UkuleleDesign/LightningUke/README.md

# LightningUke
An Electric Ukulele DIY Kit

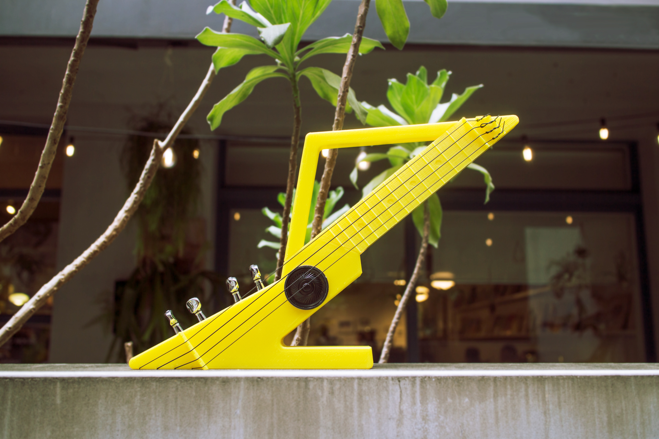
[picture p1: images/heroshot.jpg]
shot


Find out more at [Ukulele.Design](https://ukulele.design/).
