UkuleleDesign/LightningUke/ComponentList.md

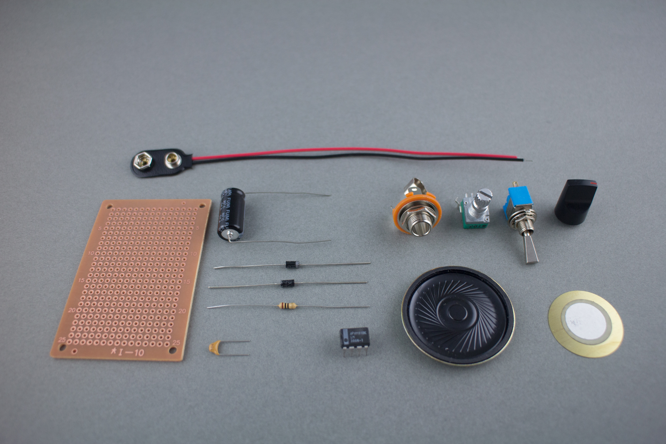
[picture p2: instructions/IMG_3865.jpg]
parts


## Electronic Parts

- pegboard x 1
- LM386 x 1
- 10Ω resistor x 1
- 0.1μF (104) capacitor x 1
- 220μF capacitor x 1
- 10KΩ potentiometer x 1
- knob x 1
- 1W 8Ω 40mm speaker x 1
- switch x 1
- 9V battery snap x 1
- 27mm piezo x 1

## Purchased Parts
- geared tuners x 4
- 21 inch ukulele nylon strings x 4
- 6.3mm jack x 1

## 3D Printed Parts
- neck x 1
- handle x 1
- body x 1
