UkuleleDesign/LightningUke/images/parts.jpg

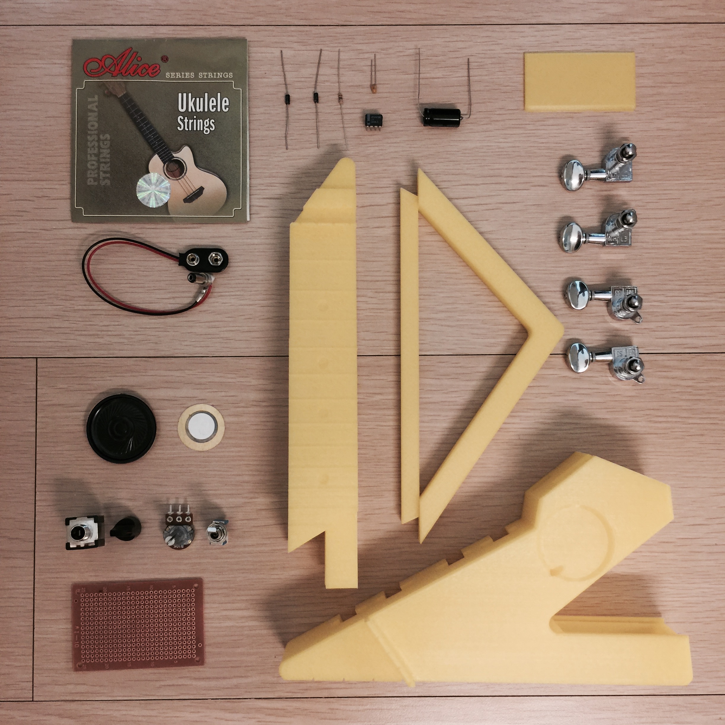
images/parts.jpg
