UkuleleDesign/LightningUke/stl/lightning-v2.step

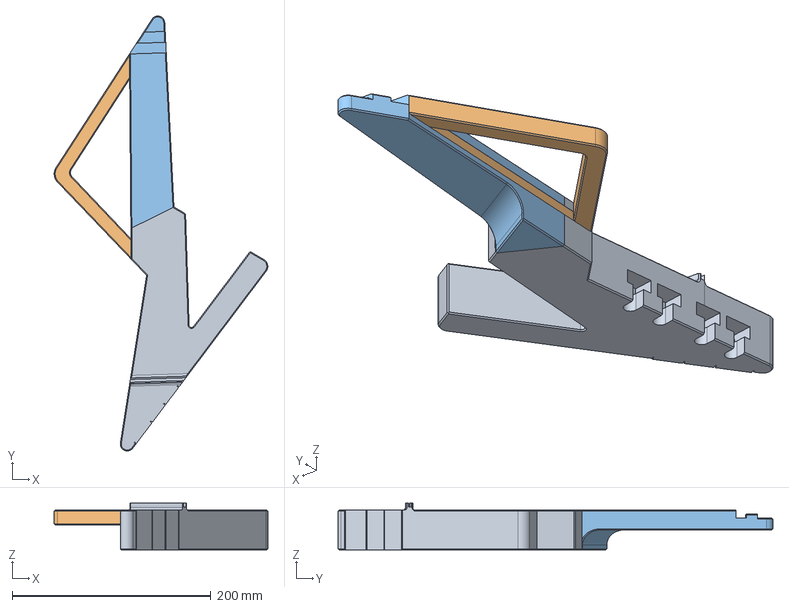
[picture p4: CAD file, 2019-11-01]
stl/lightning-v2.step
215.0 x 437.7 x 47.0 mm
