UkuleleDesign/LightningUke/stl/lightning-v21-body-solid.stl

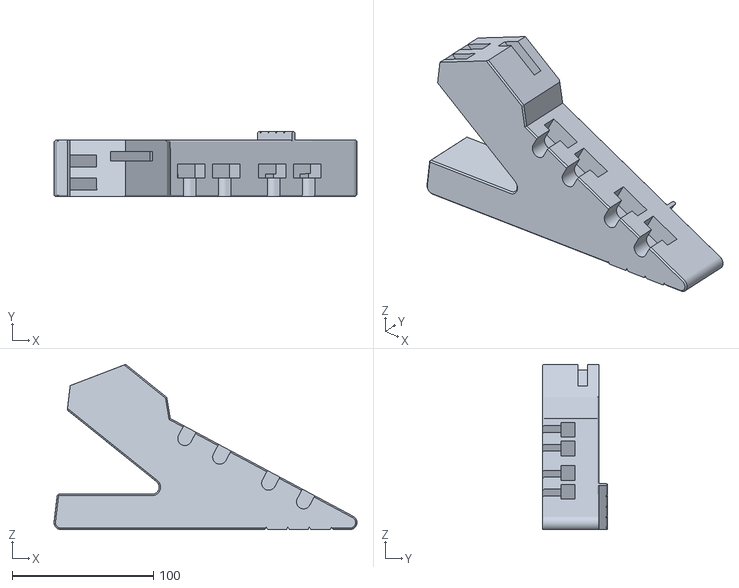
[picture p5: CAD file, 2016-09-16]
stl/lightning-v21-body-solid.stl
214.5 x 46.2 x 117.0
