UkuleleDesign/LightningUke/stl/lightning-v21-body.stl

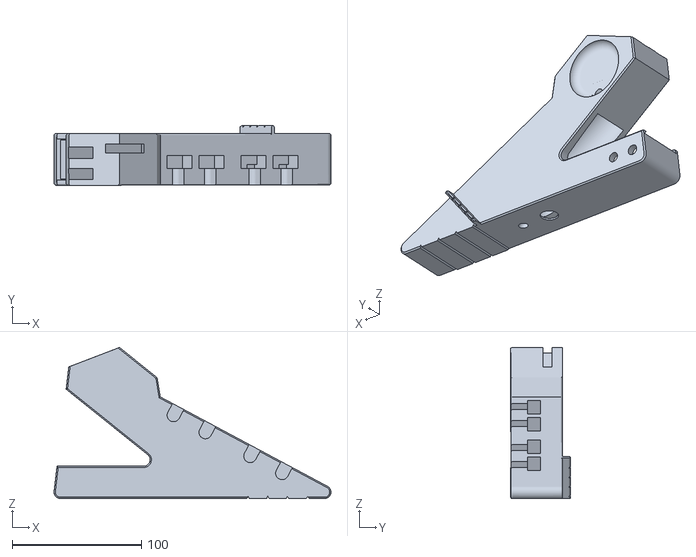
[picture p6: CAD file, 2016-09-16]
stl/lightning-v21-body.stl
214.5 x 46.2 x 117.0
