UkuleleDesign/LightningUke/stl/lightning-v20-handle.stl

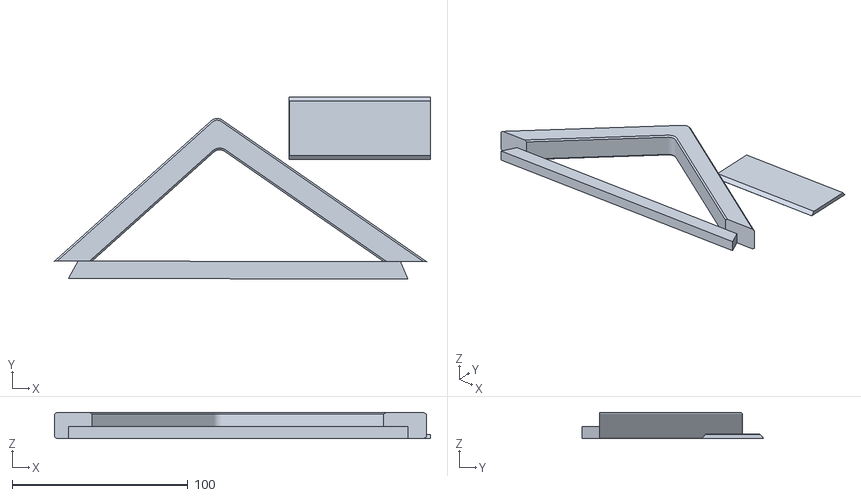
[picture p7: CAD file, 2016-08-18]
stl/lightning-v20-handle.stl
213.8 x 103.4 x 15.0
