UkuleleDesign/LightningUke/stl/lightning-v20-neck.stl

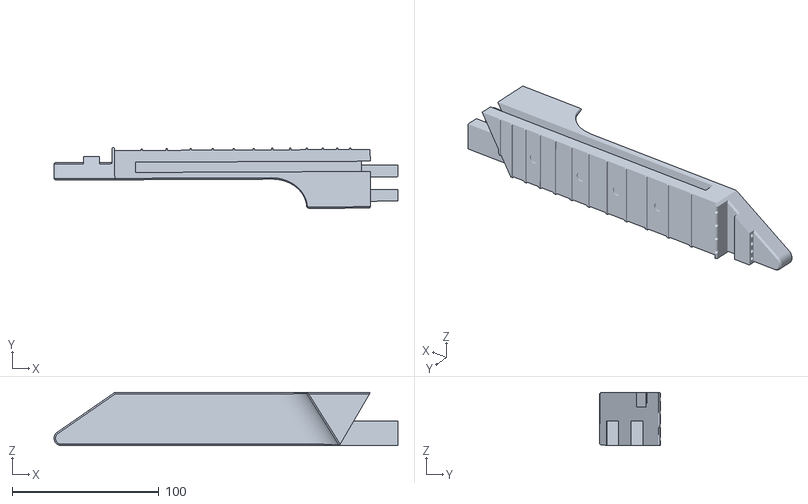
[picture p8: CAD file, 2016-08-18]
stl/lightning-v20-neck.stl
234.5 x 41.4 x 36.4
