UkuleleDesign/LightningUke/stl/lightning-v2-handle.stl

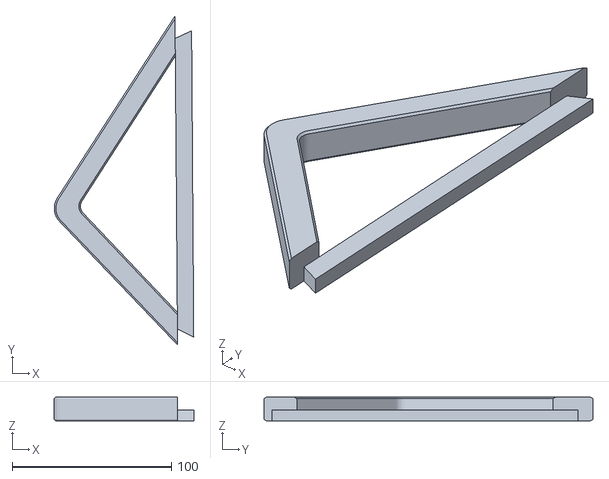
[picture p9: CAD file, 2019-11-01, an earlier design]
stl/lightning-v2-handle.stl
87.5 x 206.4 x 15.0
