UkuleleDesign/LightningUke/stl/lightning-v2-neck.stl

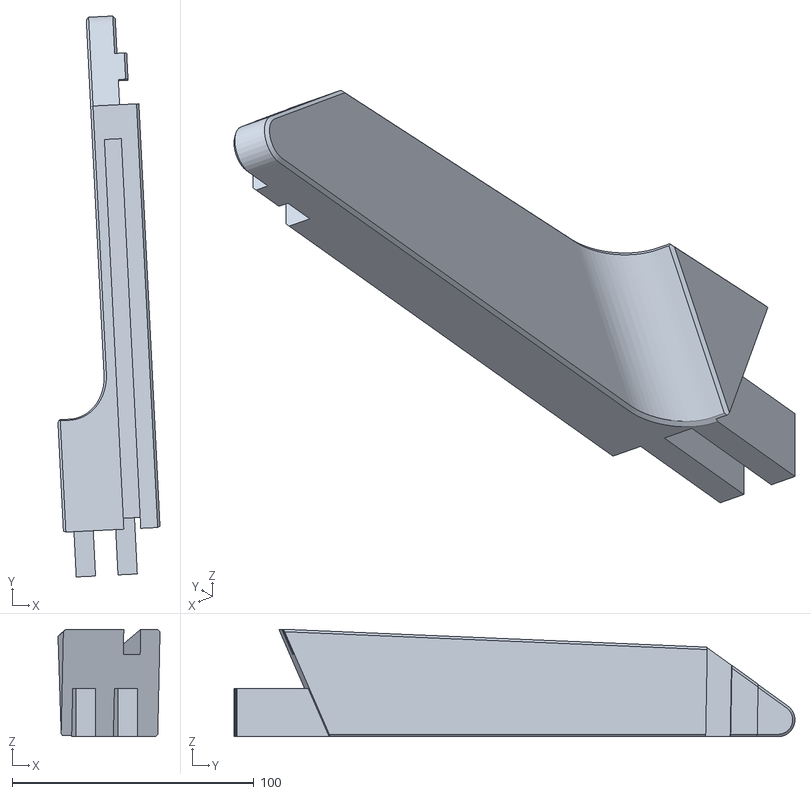
[picture p10: CAD file, 2019-11-01, an earlier design]
stl/lightning-v2-neck.stl
42.2 x 231.9 x 44.4
