UkuleleDesign/LightningUke/stl/lightning-v2-body.stl

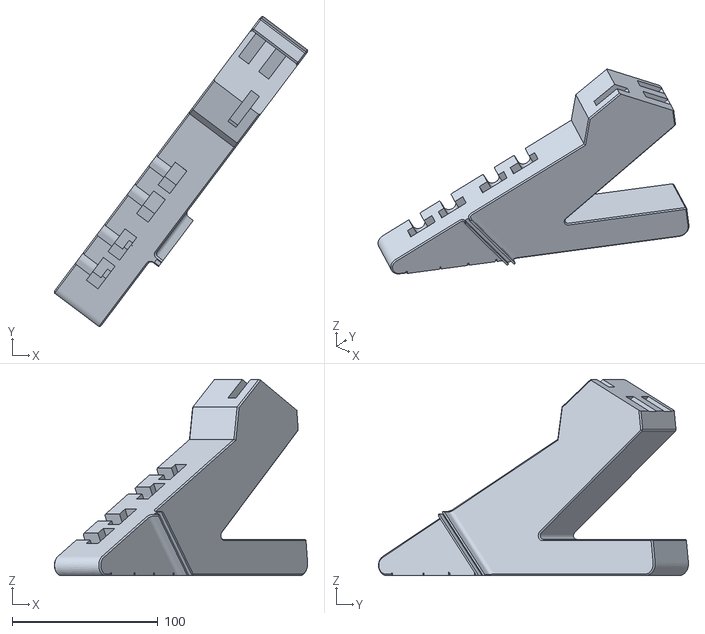
[picture p11: CAD file, 2019-11-01, an earlier design]
stl/lightning-v2-body.stl
173.9 x 212.9 x 134.7
