UkuleleDesign/LightningUke/AssemblyInstructions.md

# Lightning Uke Assembly Instructions 

## 1. Prepare Printed Parts  

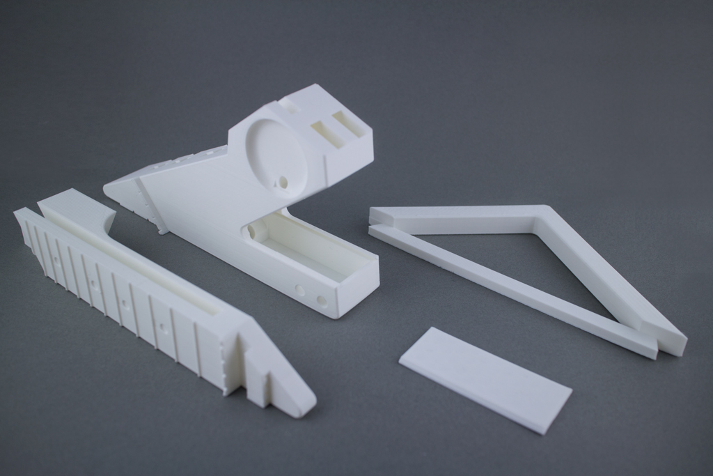
[picture p12: instructions/IMG_3761.jpg]


Download [STL files](https://github.com/UkuleleDesign/LightningUke/tree/master/stl) for 3D printing. Print all 3 files in PLA, with following configuration:

* Infill: 20%
* Layer height: 0.20 mm
* Shells: 2 
* Support material and raft: No

Depends on the printer size, you might need to rotate the model in 45 degrees

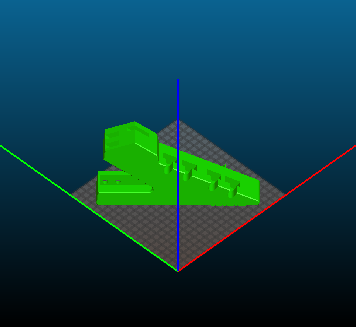
[picture p13: instructions/slic3r.png]


The whole prints takes around 15.5 hours (body: 9 hours, neck: 4 hours, handle: 2.5 hours) on a Replicator 2. You can also purchase a [DIY kit](http://ukulele.design/#purchase) from the project website
	
## 2. Assemble the Body

Slide the handle into neck, and insert joints into body

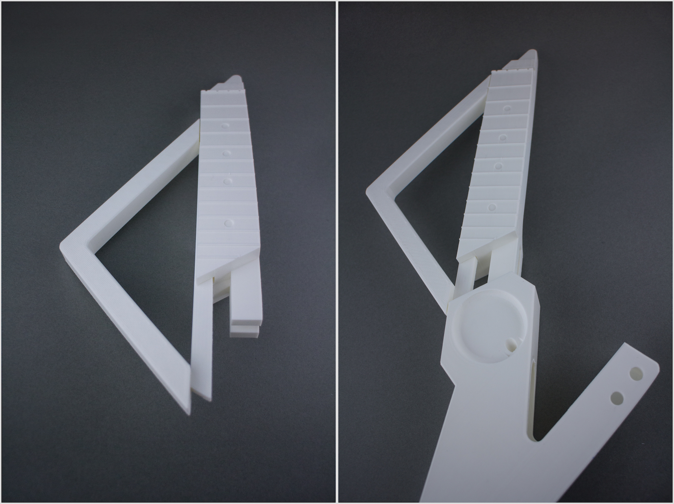
[picture p14: instructions/assemble_body.jpg]


Snap it together to finish the body 

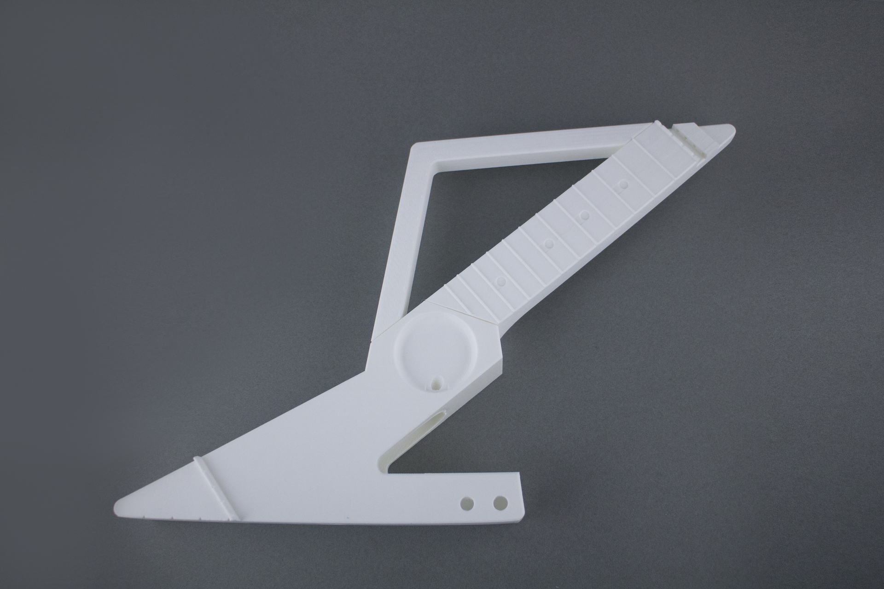
[picture p15: instructions/IMG_3788.jpg]


## 3. Install Tuners

Get 4 sealed geared tuners, note there are left and right orientations

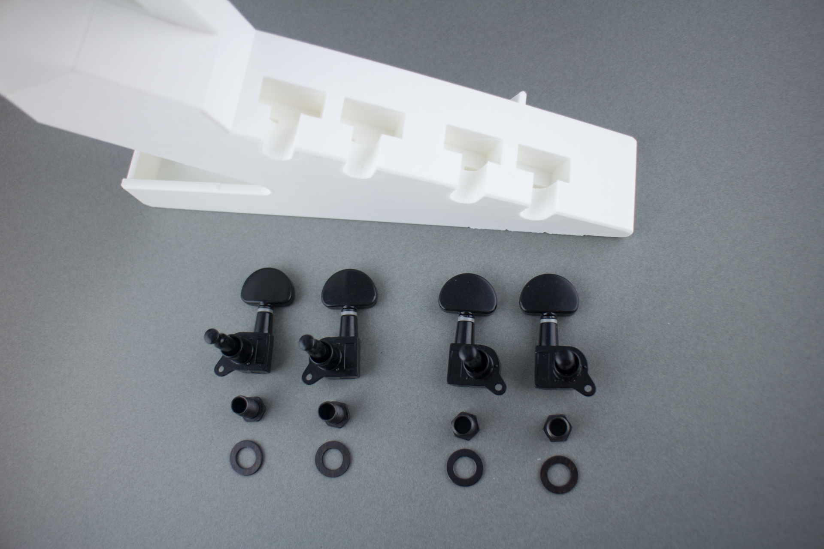
[picture p16: instructions/IMG_3799.jpg]


Slide tuners into body, tighten screw with washer

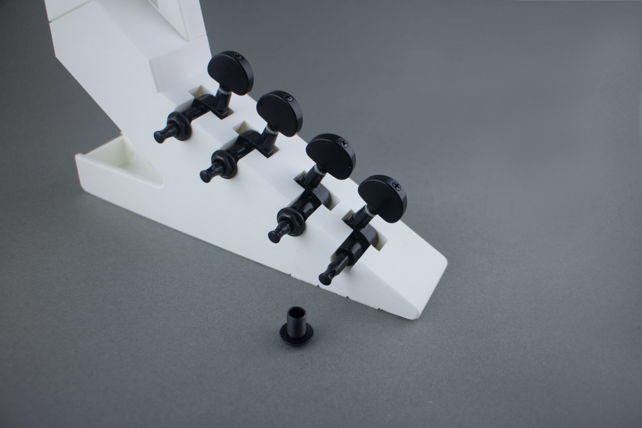
[picture p17: instructions/IMG_3805.jpg]


## 4. String It Up

Get a set of 21 inch (soprano) ukulele strings 

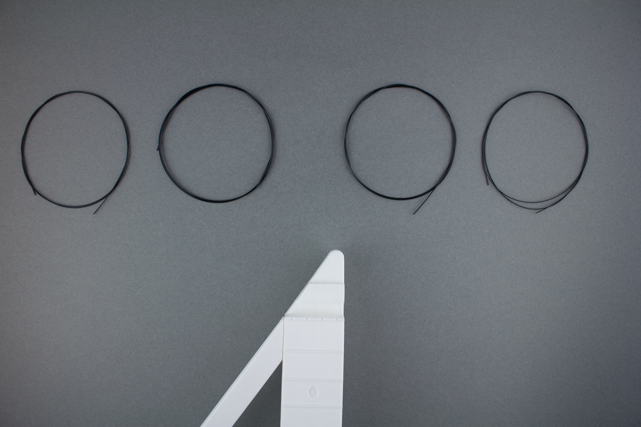
[picture p18: instructions/IMG_3813.jpg]


Start with the 4th string, insert it into the top-most hole of headstock 

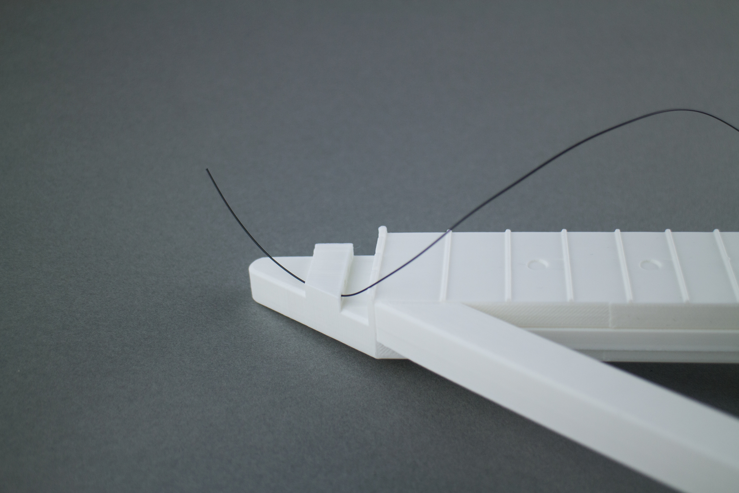
[picture p19: instructions/IMG_3818.jpg]


Go around itself for a loop

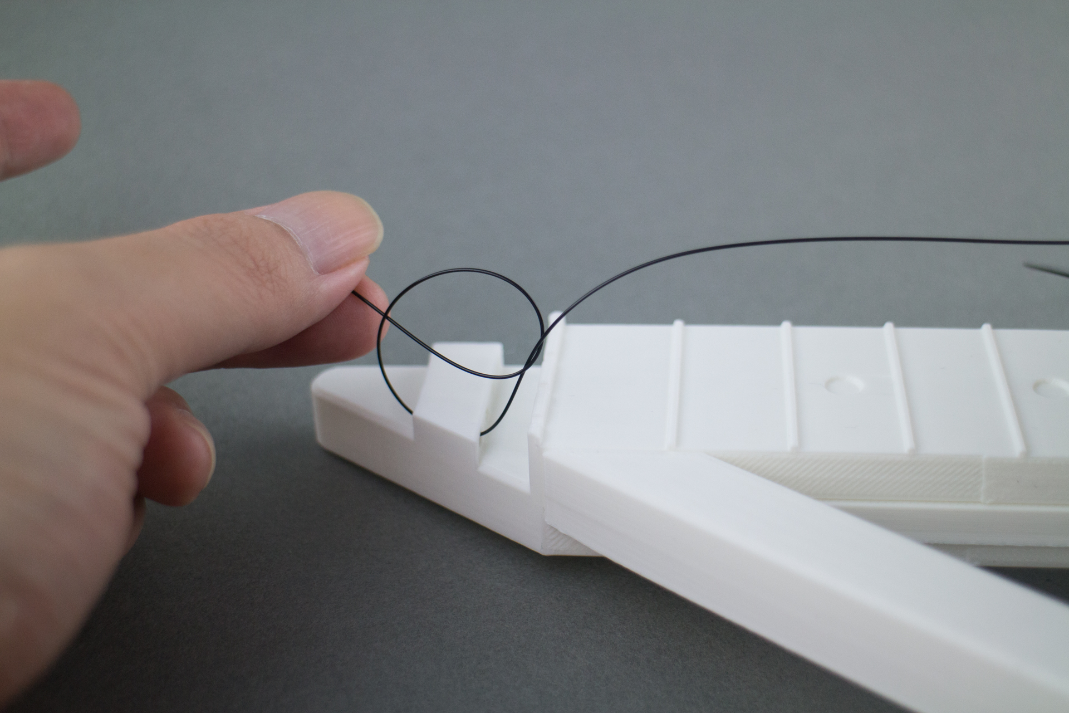
[picture p20: instructions/IMG_3822.jpg]


Make two more loops in the same direction 

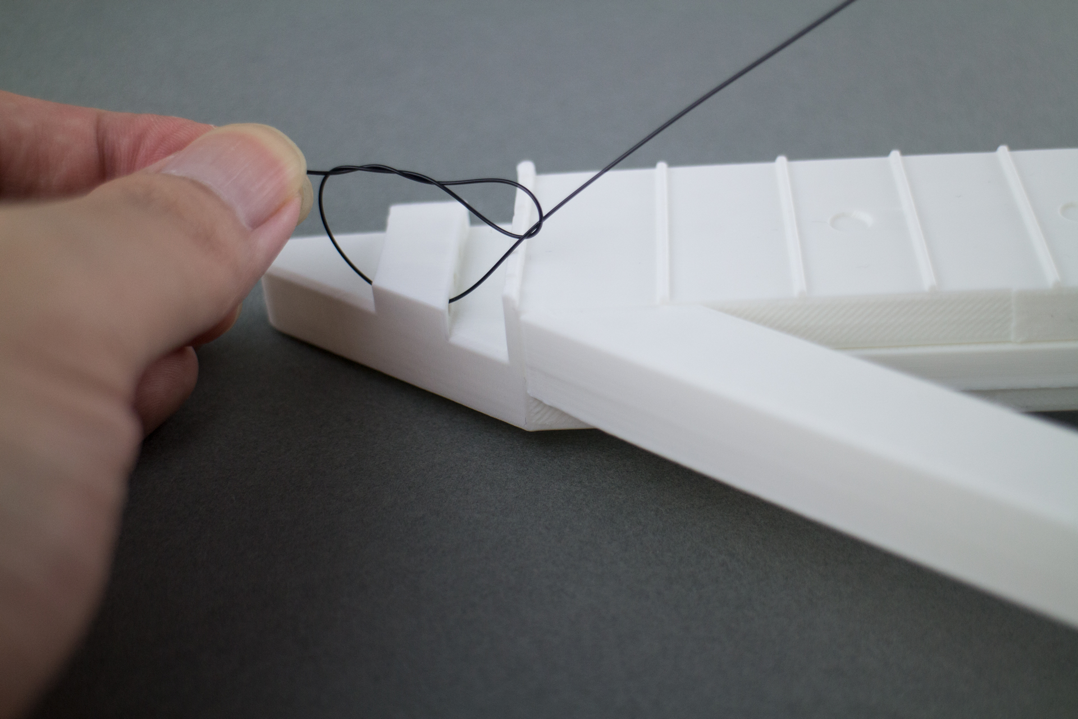
[picture p21: instructions/IMG_3823.jpg]


Pull on the long end of string to tighten the knot

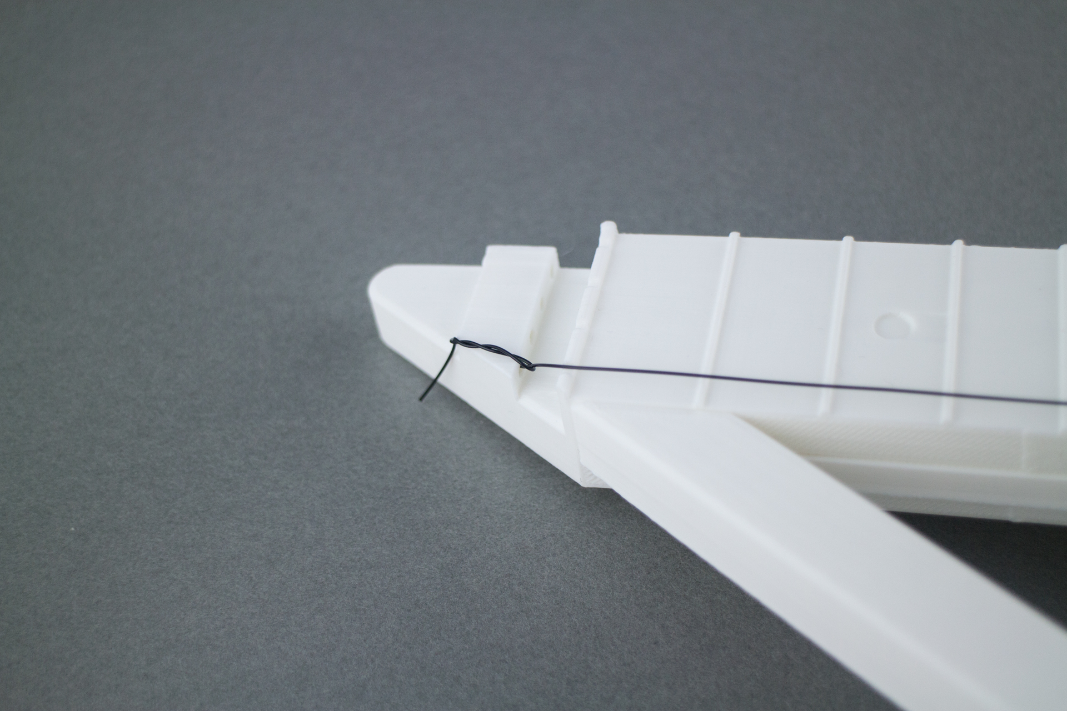
[picture p22: instructions/IMG_3825.jpg]


Wrap the string over the bridge and around the body, insert into the tuner peg hole 

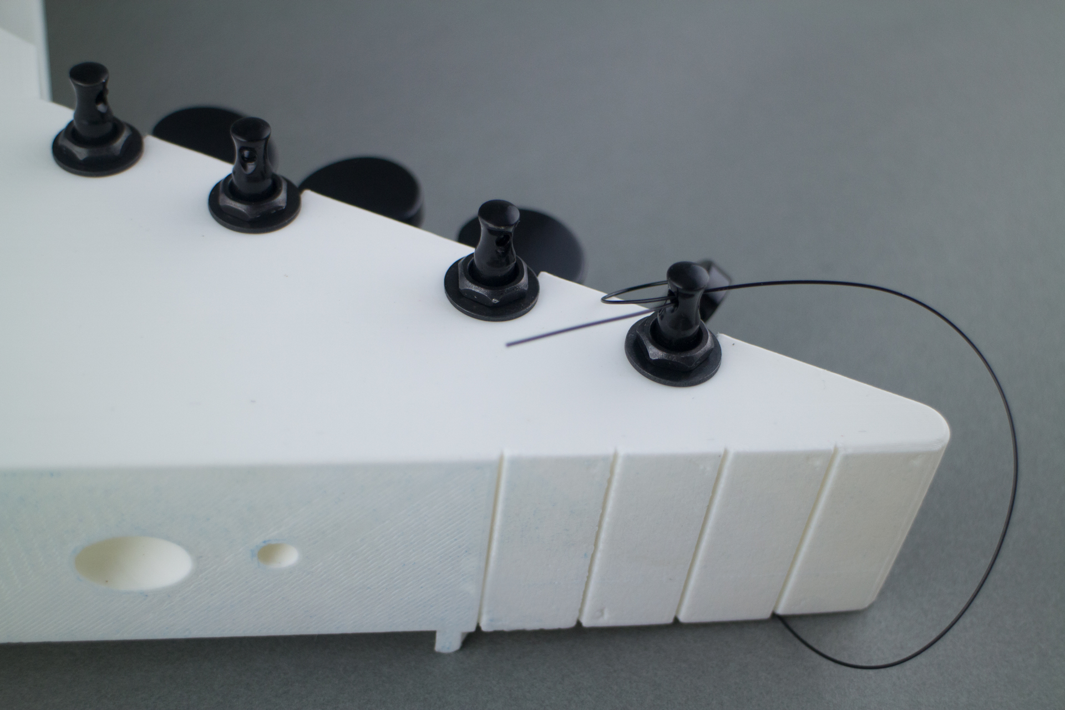
[picture p23: instructions/IMG_3836.jpg]


Tighten and tune

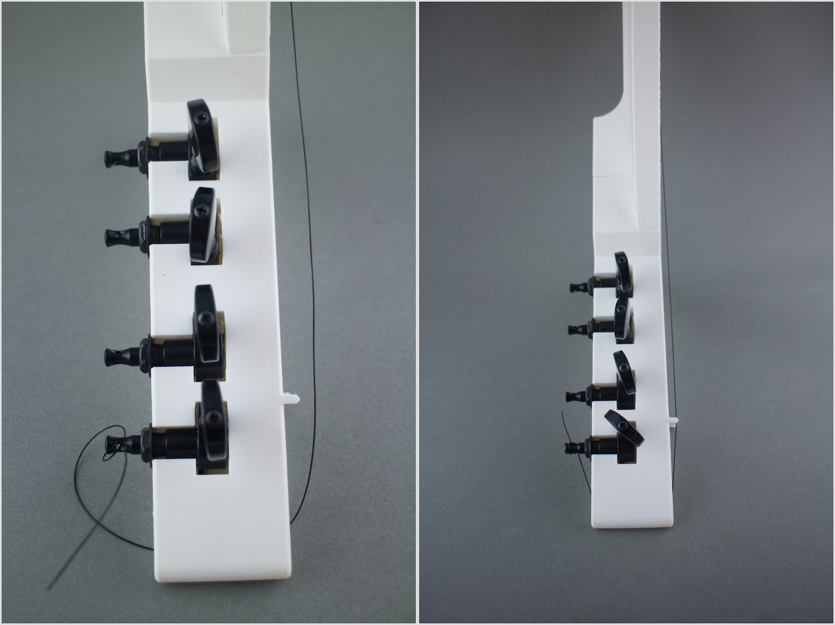
[picture p24: instructions/tuner.jpg]


Finish rest of the 3 strings 

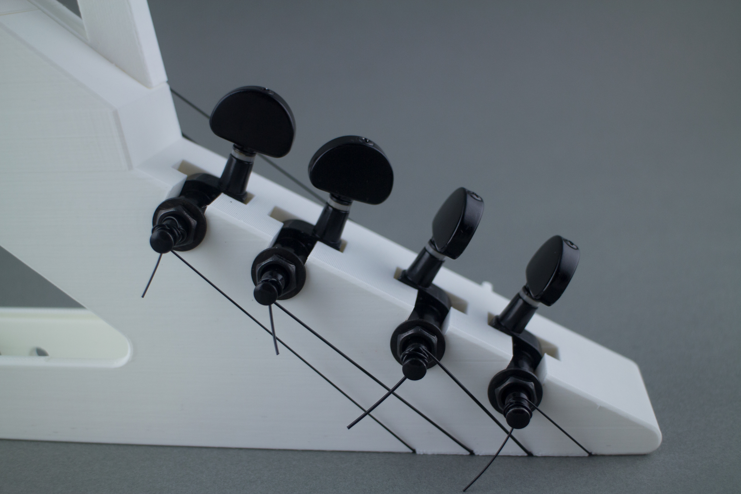
[picture p25: instructions/IMG_3853.jpg]


Make sure strings sit in their corresponding bridge slots

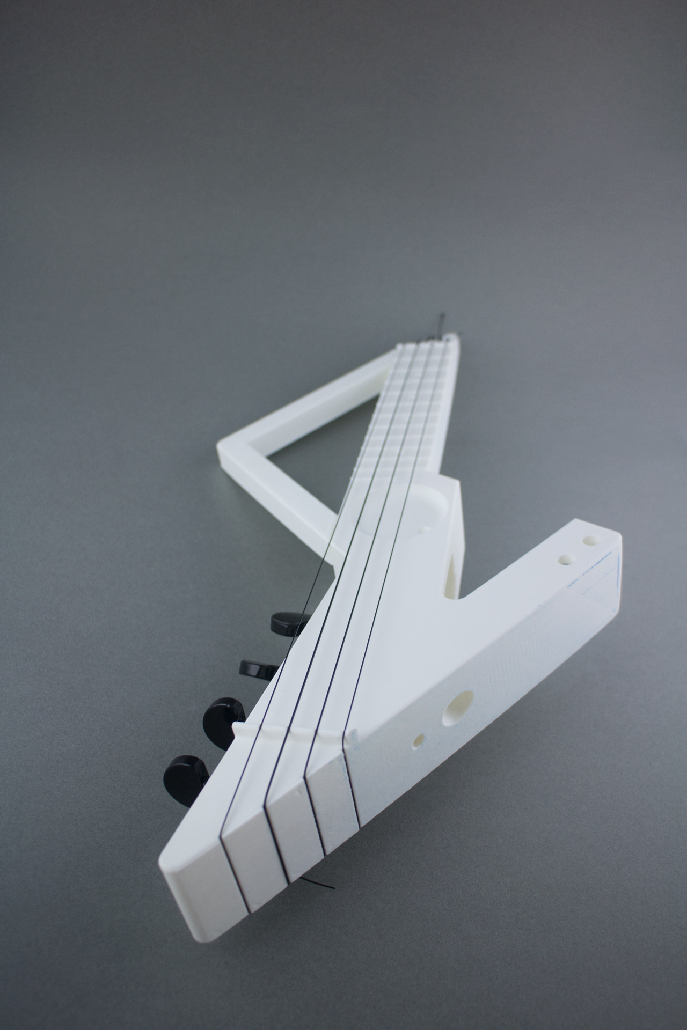
[picture p26: instructions/IMG_3844.jpg]


And in nut slots as well, trim the strings as needed

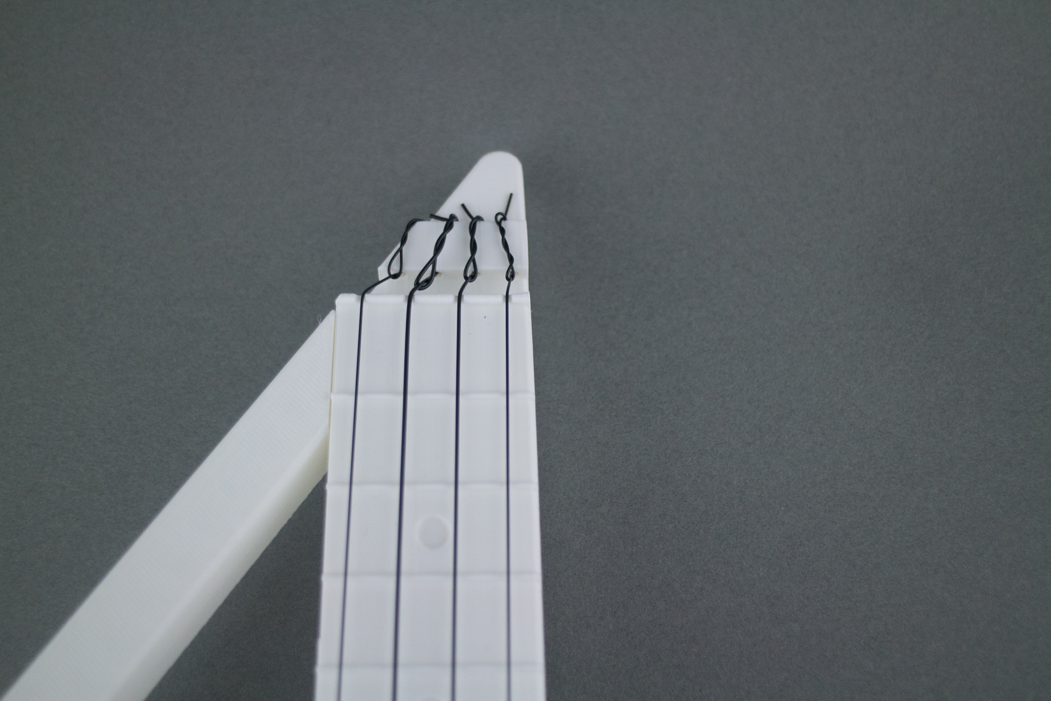
[picture p27: instructions/IMG_3858.jpg]


Now you have a non-electrified ukulele!

## 5. Solder the Circuit 

Get your tools and electronic parts based on the [component list](https://github.com/UkuleleDesign/LightningUke/blob/master/ComponentList.md)

 

Solder the amplifier circuit by using this layout, or adjust as you need. There are many examples of LM386 based amplifier circuit can be found online

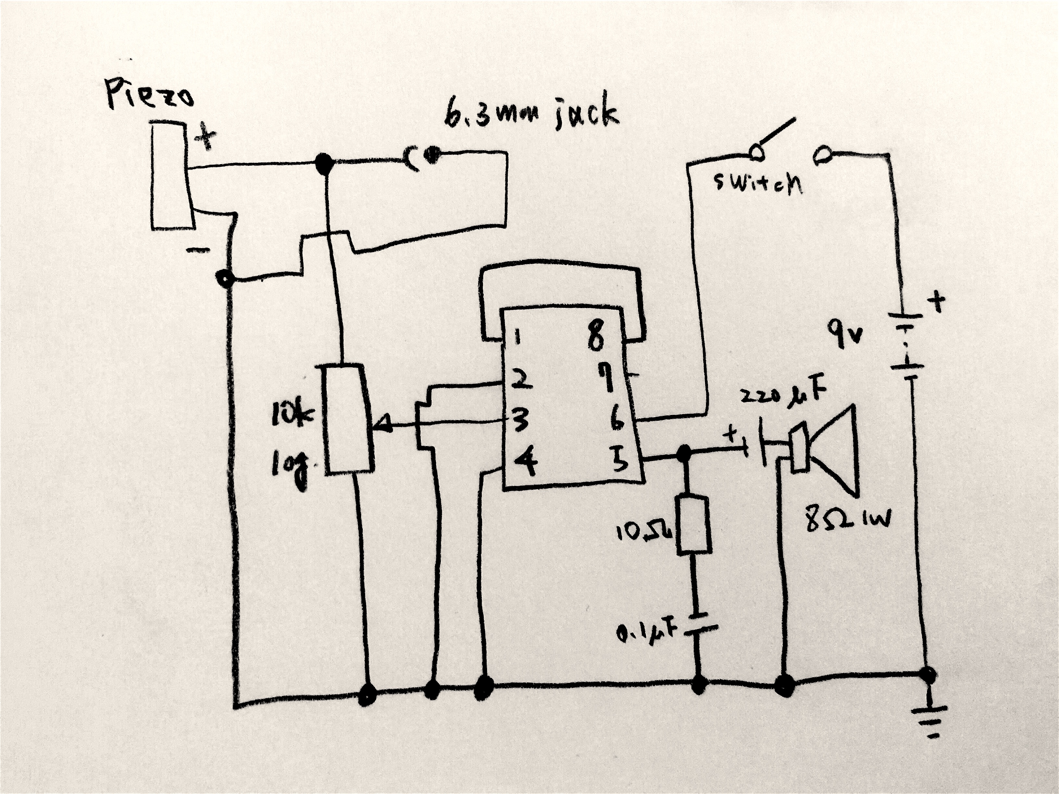
[picture p28: instructions/lm386-circuit.jpg]

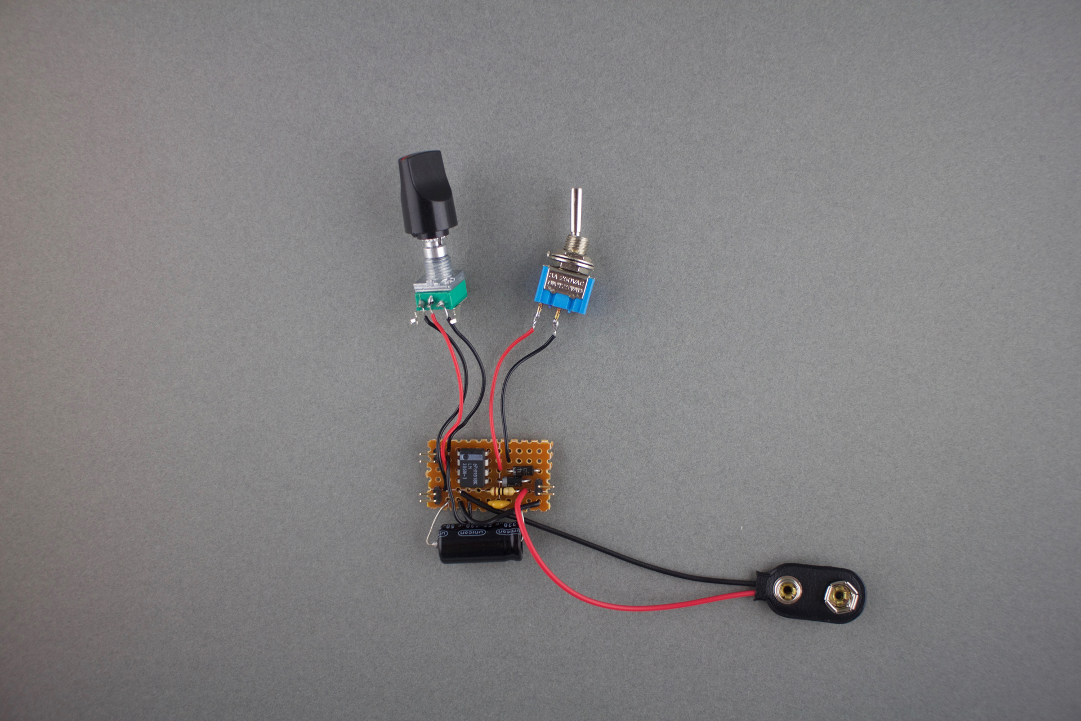
[picture p29: instructions/IMG_3868.jpg]


Solder the speaker, piezo and 6.3mm jack with wires

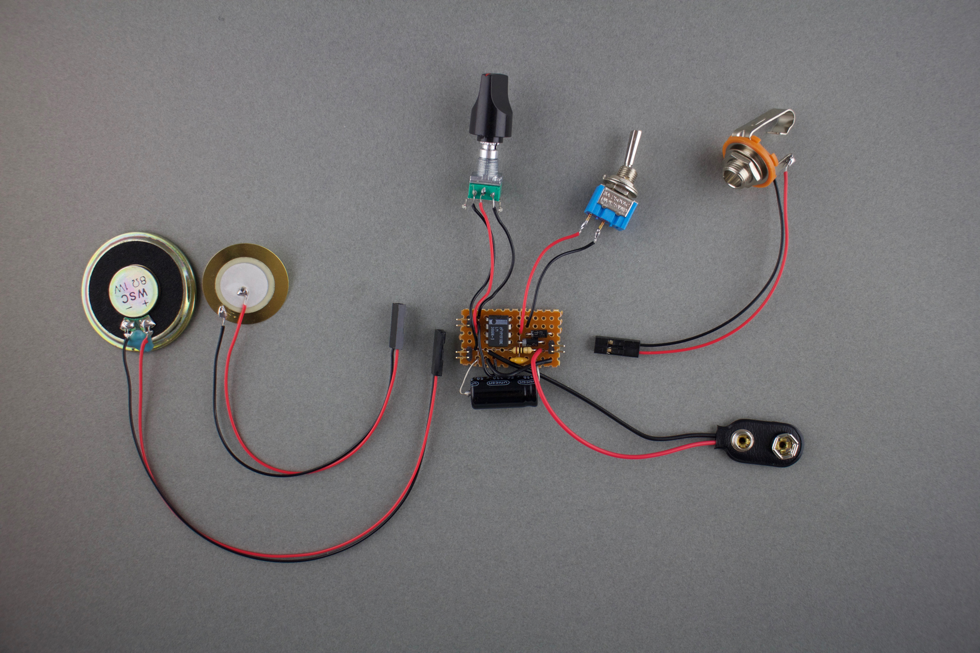
[picture p30: instructions/IMG_3872.jpg]


## 6. Assemble the Electronic Parts

Slide the speaker underneath strings, glue it in the cavity

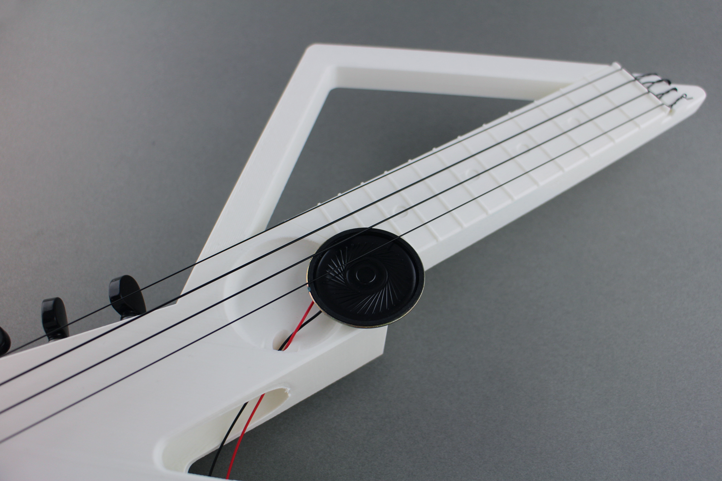
[picture p31: instructions/IMG_3875.jpg]


Glue the piezo at the bottom of body 

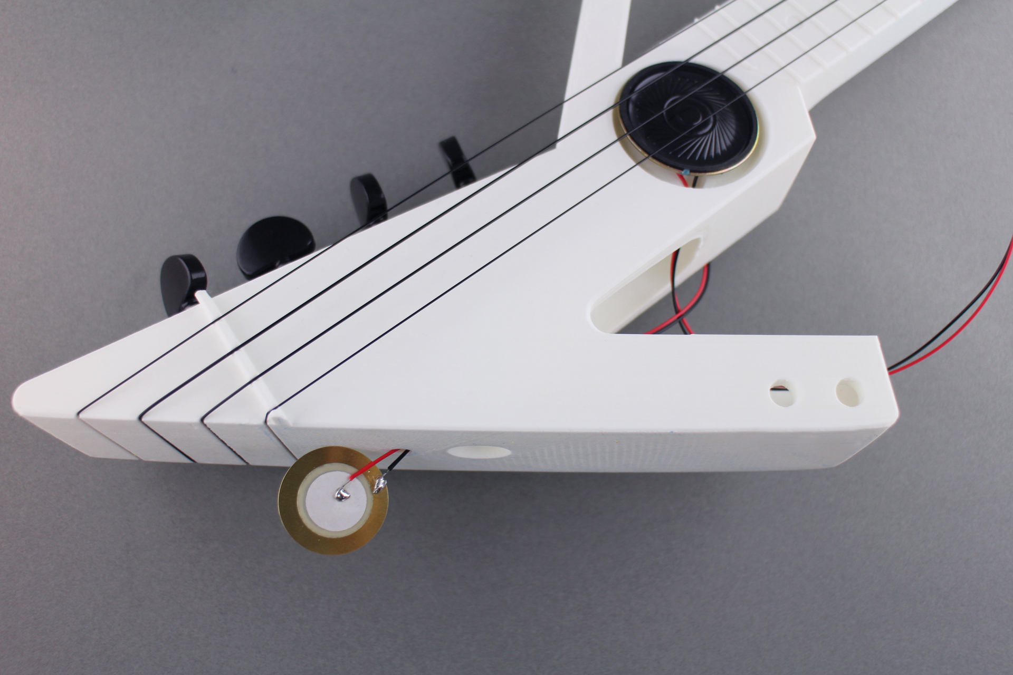
[picture p32: instructions/IMG_3880.jpg]


Install switches, jack and circuit board, save some space for 9V battery

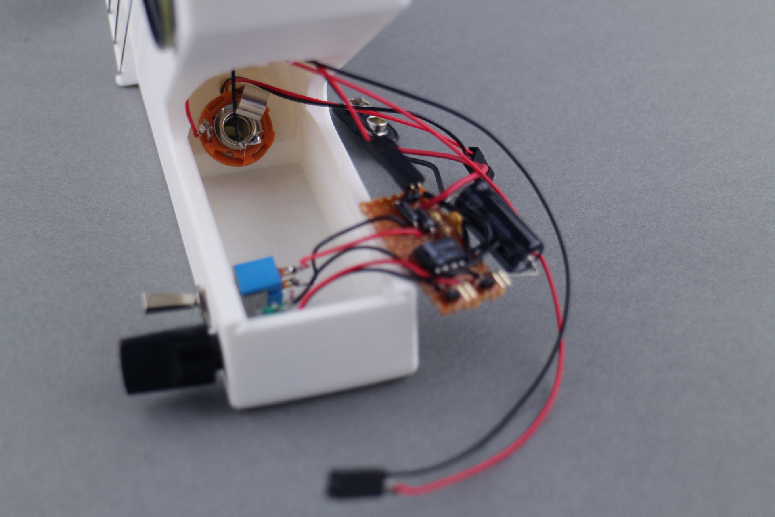
[picture p33: instructions/IMG_3890.jpg]


Snap the battery in and insert the cover, your Lightning Uke is done! 

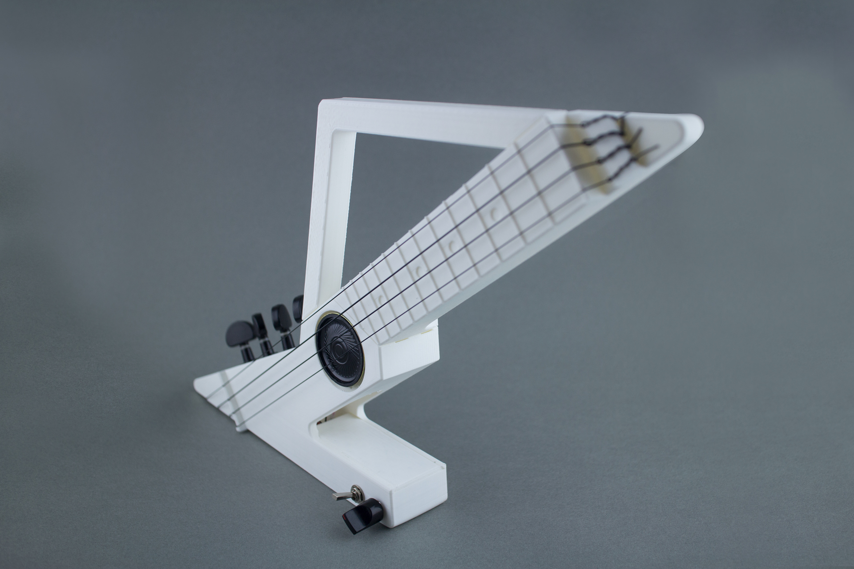
[picture p34: instructions/IMG_3922.jpg]

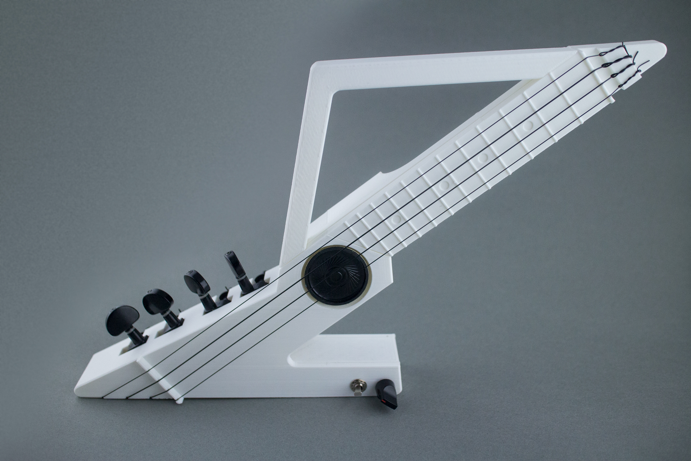
[picture p35: instructions/IMG_3900.jpg]
