UkuleleDesign/LightningUke/instructions/AssemblyInstructions-zh.md

# 閃電麗麗組裝說明

## 1. 準備零件 



下載 [STL 檔案](https://github.com/UkuleleDesign/LightningUke/tree/master/stl)並準備 3D 列印，建議的設定如下：

* Infill: 20%
* Layer height: 0.20 mm
* Shells: 2 
* Support material and raft: No

視熱床尺寸，可能需要將模型旋轉 45° 擺放



以 Replicator 2 列印約 15.5 個小時（琴身 9 小時、琴頸 4 小時、握把 2.5 小時）。你也可以至電烏克製作所的網站購買列印完成的[套件包](http://ukulele.design/tw/#purchase)
	
## 2. 組合琴身 

將握把 (handle) 滑入琴頸 (neck) 槽中，並將卡榫嵌合至琴身 (body) 上



推到底扣緊即完成



## 3. 安裝弦鈕

準備弦鈕一套四顆，注意弦鈕有左右兩個方向



滑入琴身槽中，套上墊片並鎖緊



## 4. 綁弦

準備 21 吋烏克麗麗琴弦一套四條



首先將第 4 弦穿入琴頭上端弦孔中



拉回繞一個圈



多繞兩圈後拉緊，讓弦卡進上弦枕




繞過琴身尖頭，穿進弦鈕孔洞後繞一圈，拉緊



順時針旋轉弦鈕，直至琴弦稍微繃緊，卡進琴頭底部的溝槽中，待稍後調音



依序把剩下 1 至 3 弦綁完




修剪多餘的長度，並確定琴弦都卡進正確的溝槽中



現在你有一把不插電的烏克麗麗了！

## 5. 焊接電路

根據[零件清單](https://github.com/UkuleleDesign/LightningUke/blob/master/ComponentList.md)準備電子元件、銲錫與多芯線

 

依照電路圖完成擴大器電路




焊接喇叭、拾音器與導線接頭



## 6. 連接電子元件 

首先將喇叭從弦底下穿過，以快乾膠固定在凹槽處



拾音器從琴底拉線，也用快乾固定在底部



將開關、導線孔與電路板放進琴身空間固定，留下 9V 電池位置



扣上電池、闔上蓋子後，閃電麗麗就完成啦！
