UkuleleDesign/LightningUke/instructions/IMG_3780.jpg

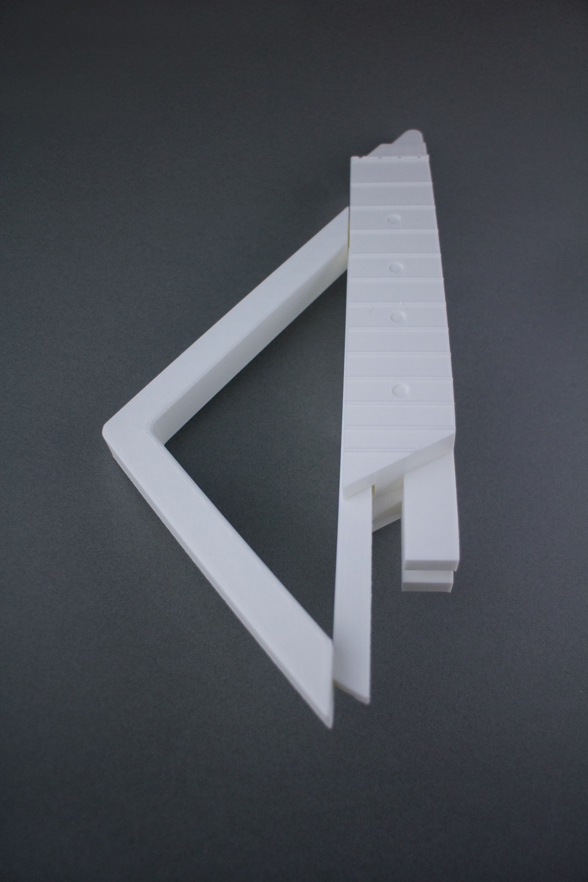
instructions/IMG_3780.jpg
