UkuleleDesign/LightningUke/instructions/IMG_3782.jpg

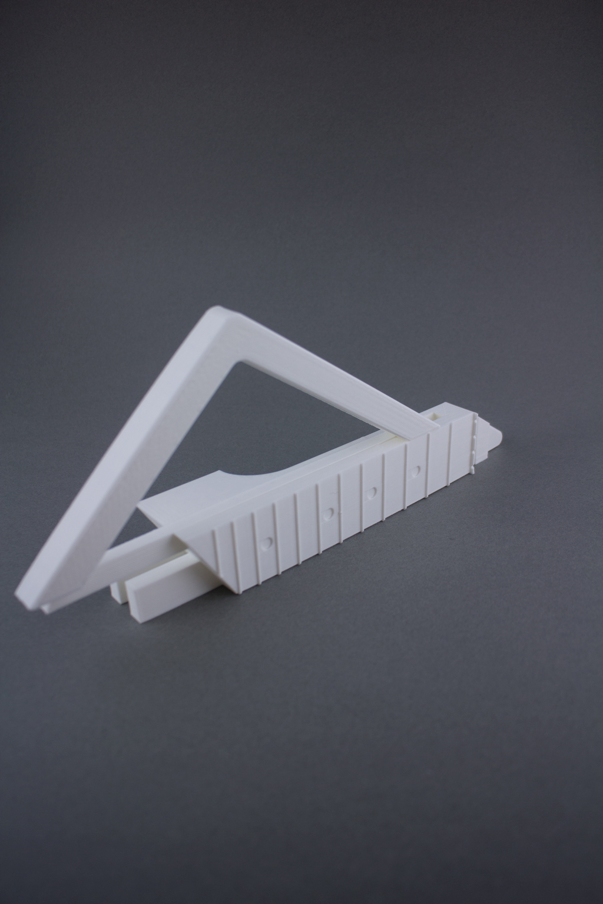
instructions/IMG_3782.jpg
