UkuleleDesign/LightningUke/instructions/IMG_3786.jpg

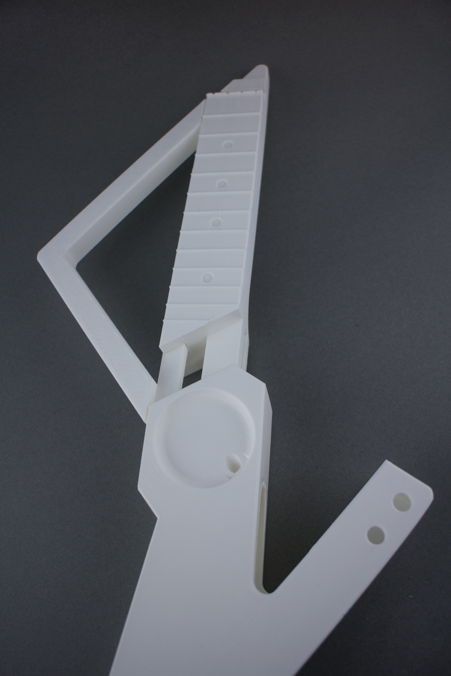
instructions/IMG_3786.jpg
