UkuleleDesign/LightningUke/instructions/IMG_3796.jpg

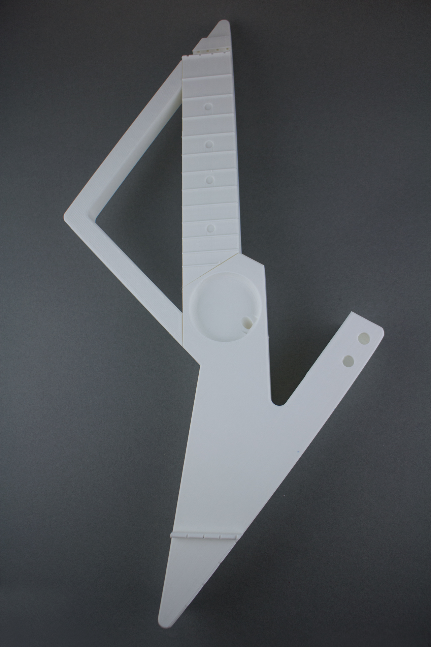
instructions/IMG_3796.jpg
