UkuleleDesign/LightningUke/instructions/IMG_3827.jpg

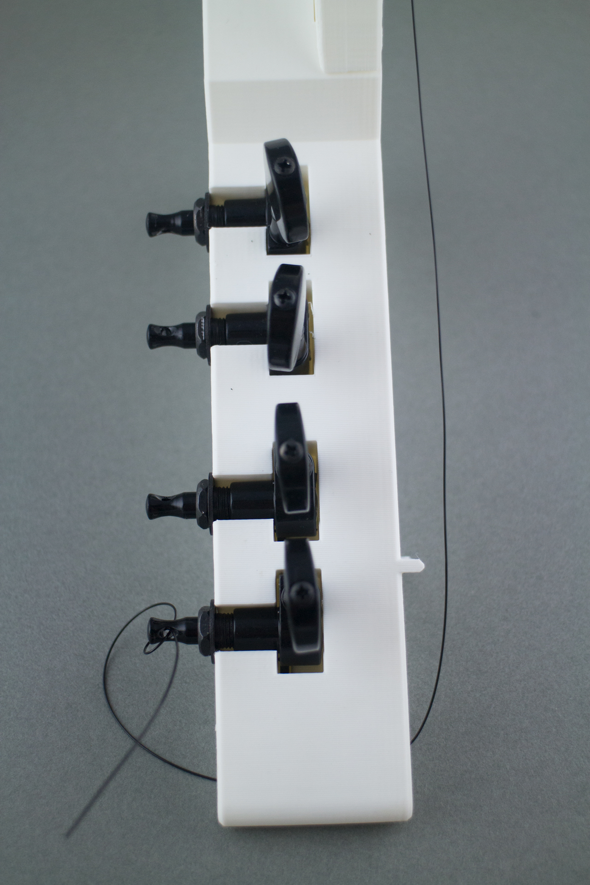
instructions/IMG_3827.jpg
