UkuleleDesign/LightningUke/instructions/IMG_3837.jpg

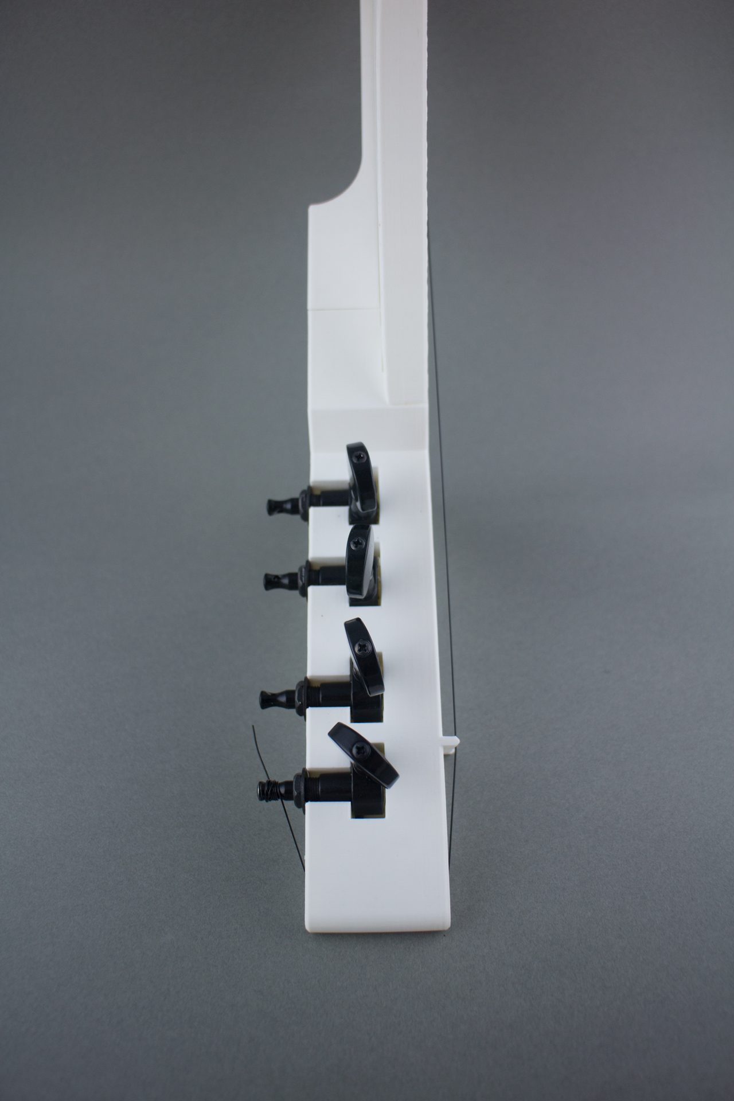
instructions/IMG_3837.jpg
