UkuleleDesign/LightningUke/instructions/IMG_3888.jpg

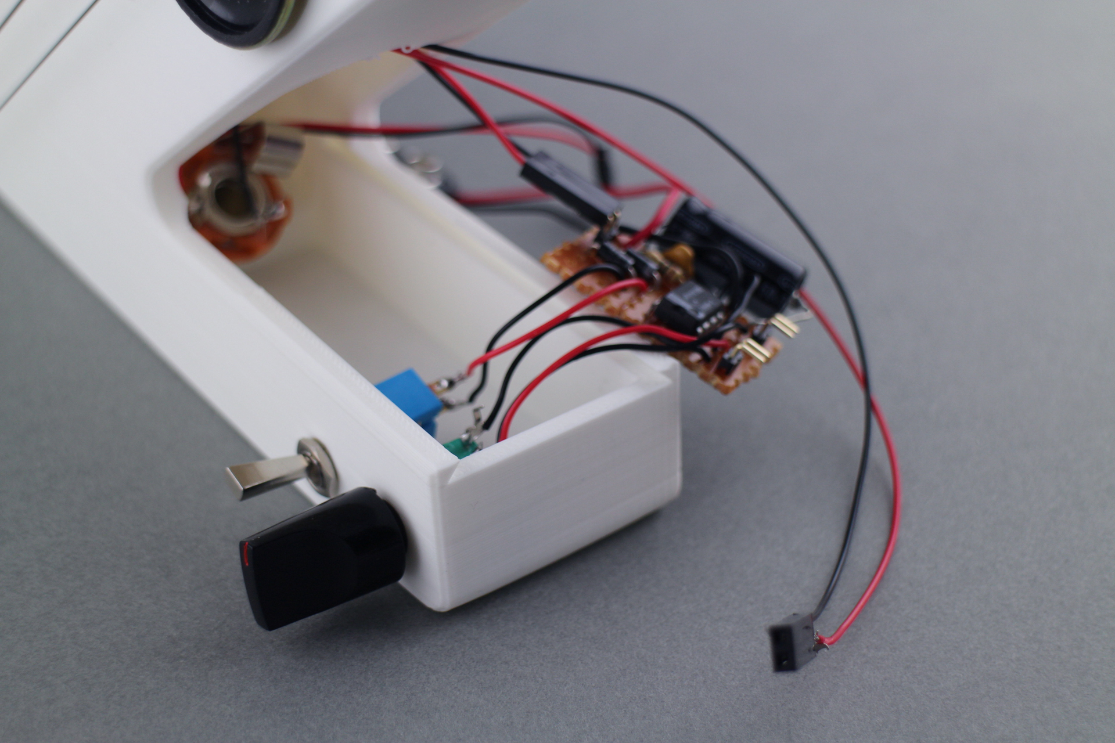
instructions/IMG_3888.jpg
