UkuleleDesign/LightningUke/instructions/IMG_3902.jpg

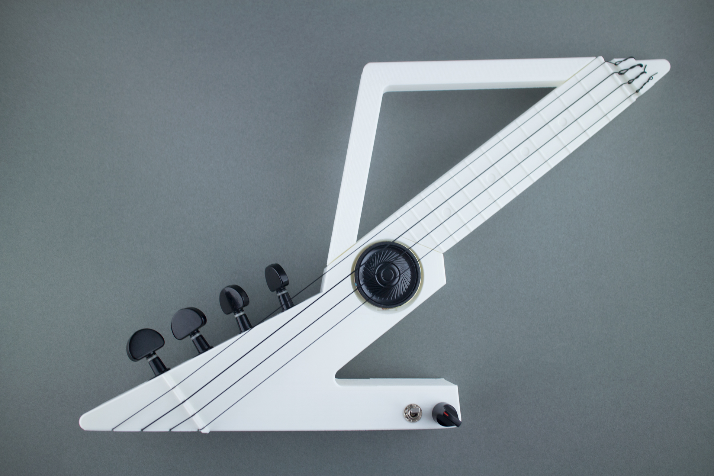
instructions/IMG_3902.jpg
