UkuleleDesign/LightningUke/instructions/IMG_3903.jpg

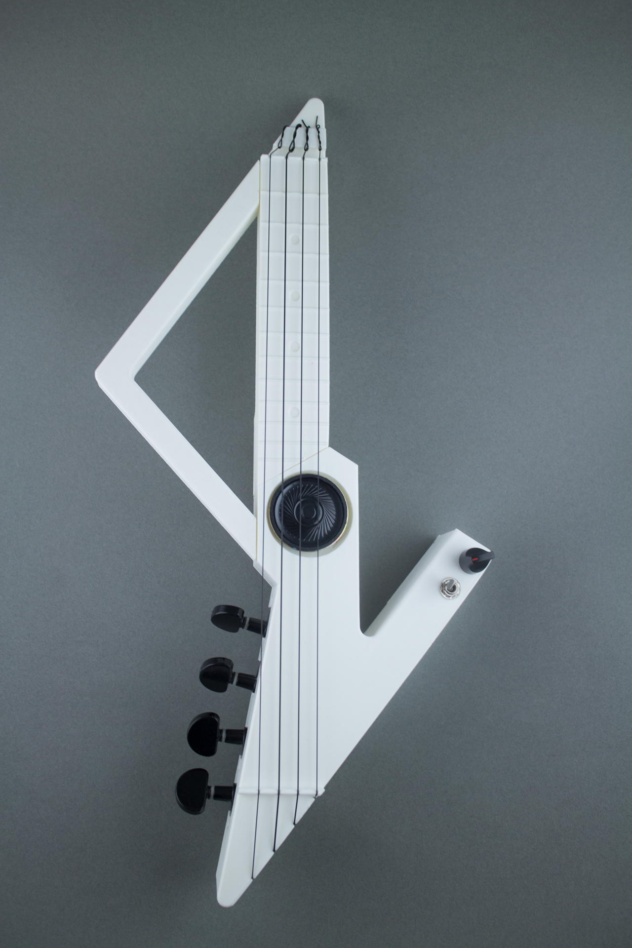
instructions/IMG_3903.jpg
