UkuleleDesign/LightningUke/instructions/IMG_3906.jpg

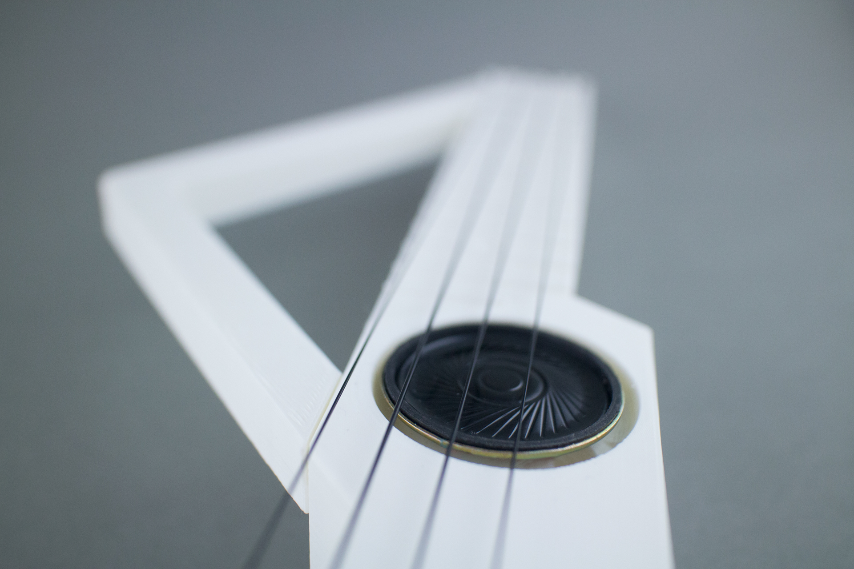
instructions/IMG_3906.jpg
