UkuleleDesign/LightningUke/instructions/IMG_3910.jpg

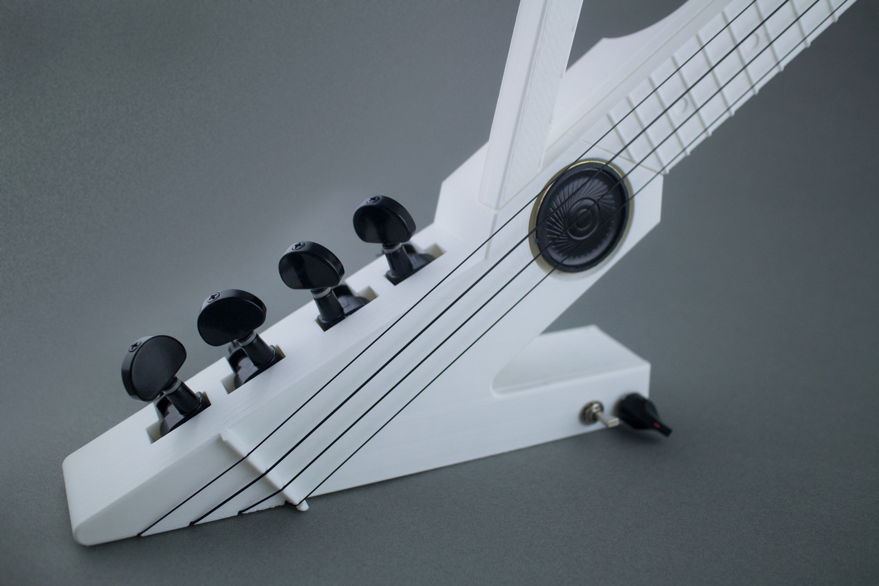
instructions/IMG_3910.jpg
