UkuleleDesign/LightningUke/instructions/IMG_3912.jpg

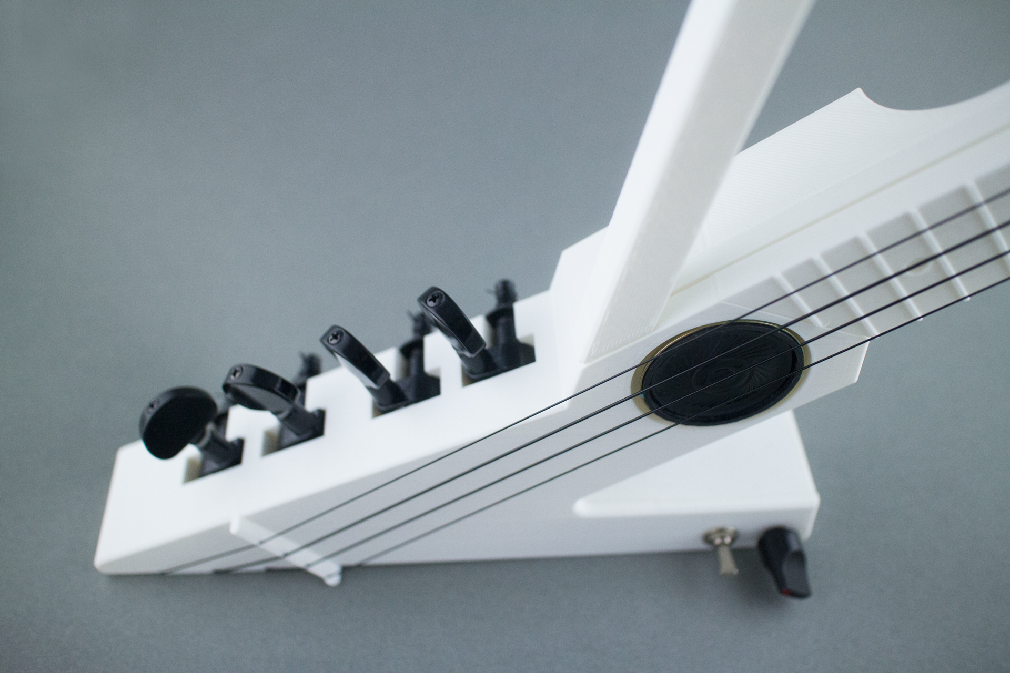
instructions/IMG_3912.jpg
