UkuleleDesign/LightningUke/instructions/IMG_3915.jpg

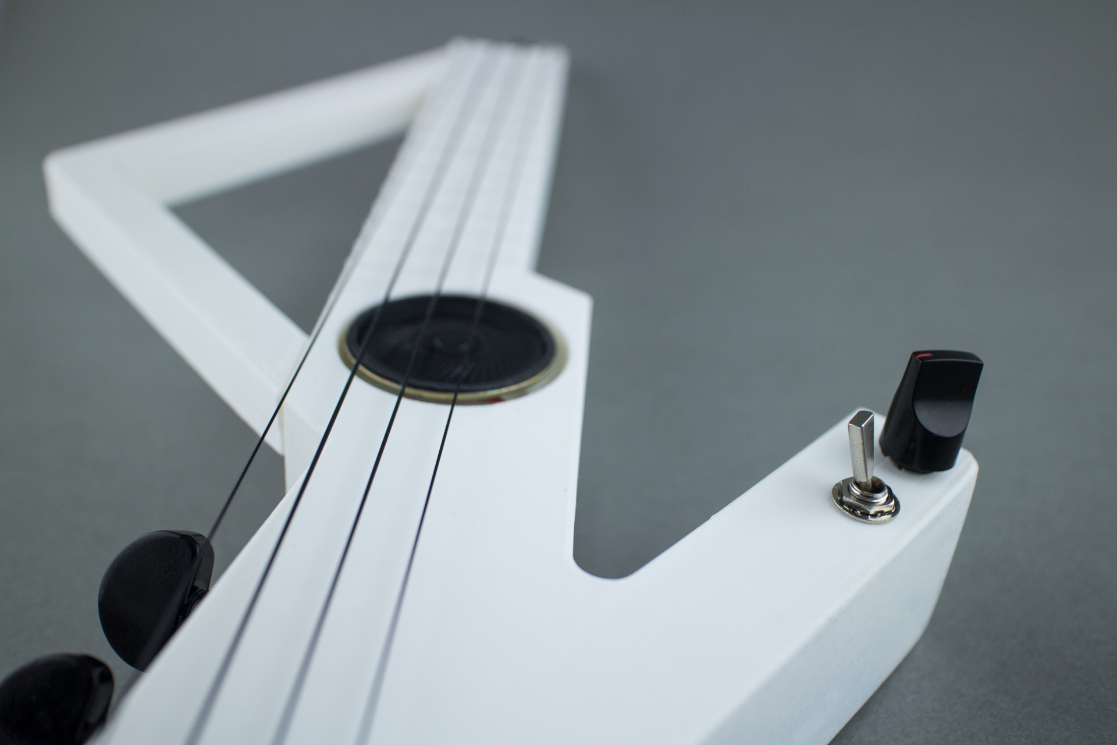
instructions/IMG_3915.jpg
