UkuleleDesign/LightningUke/instructions/IMG_3920.jpg

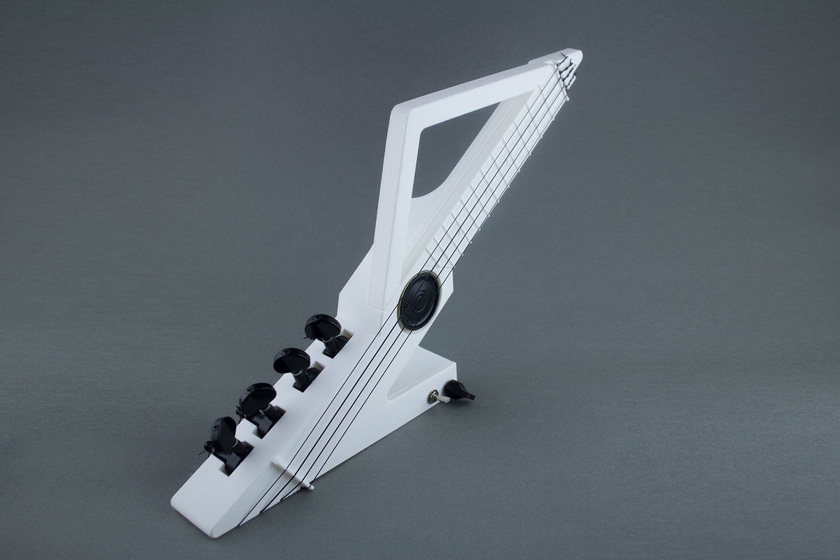
instructions/IMG_3920.jpg
