UkuleleDesign/LightningUke/instructions/IMG_3926.jpg

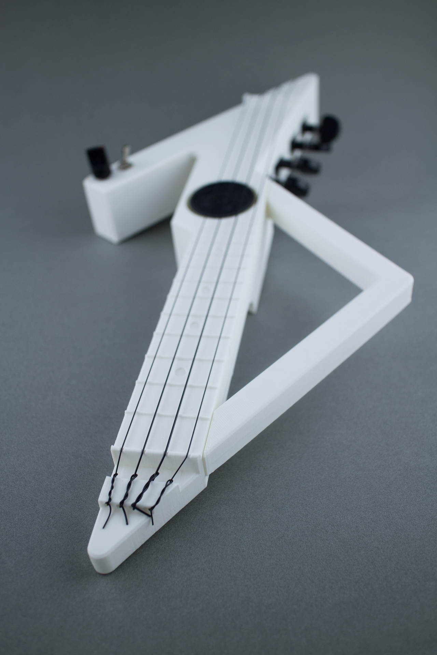
instructions/IMG_3926.jpg
