UkuleleDesign/LightningUke/instructions/IMG_7169.JPG

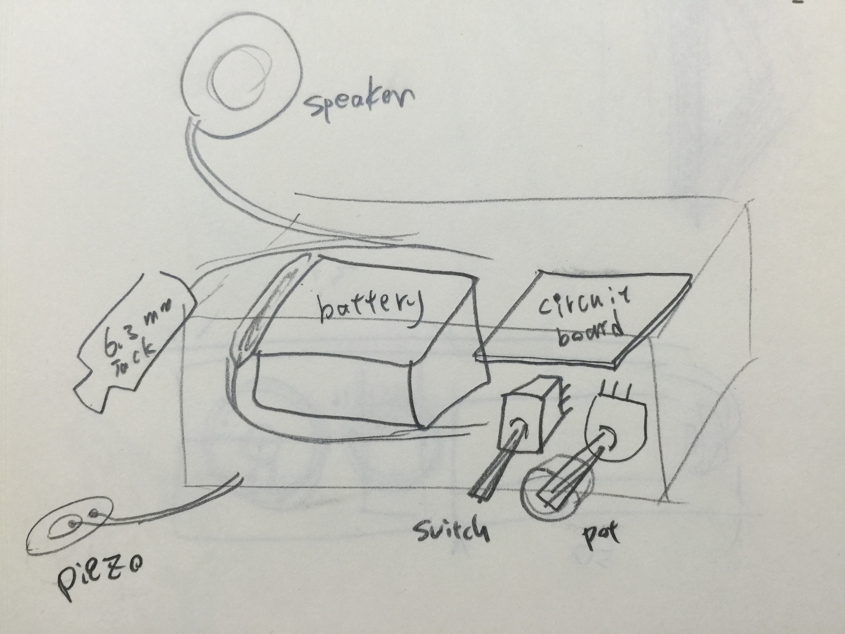
instructions/IMG_7169.JPG
