UkuleleDesign/LightningUke/(commit log)

2016-08-18 Add stl files
    [lightning-v20-body.stl, lightning-v20-handle.stl, lightning-v20-neck.stl]
2016-09-16 Adjust the body
    [lightning-v20-body.stl, lightning-v21-body.stl]
2016-09-16 Add solid body STL
    [lightning-v21-body-solid.stl]
2016-09-17 Update circuit layout
2019-11-01 Revision 2
    [lightning-v2-body.stl, lightning-v2-handle.stl, lightning-v2-neck.stl, lightning-v2.step]
